Normansrule/solar-rover/hardware/stl/remote_case_bottom.stl

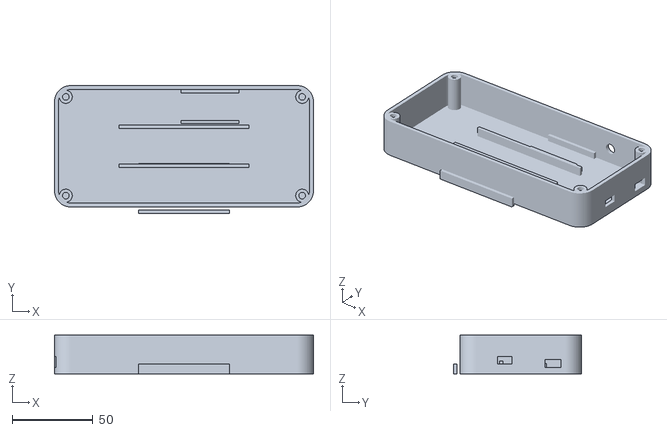
[picture p11: CAD file, 2026-11-06]
hardware/stl/remote_case_bottom.stl
160.0 x 79.0 x 24.0
