Normansrule/solar-rover/hardware/stl/roof_tray_rear.stl

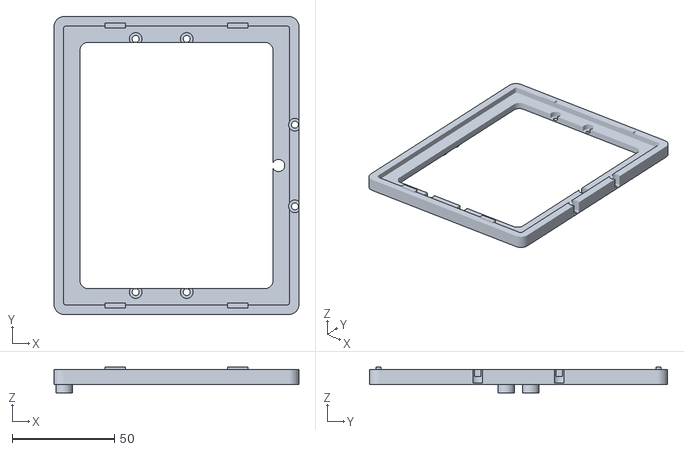
[picture p12: CAD file, 2026-11-06]
hardware/stl/roof_tray_rear.stl
120.0 x 146.0 x 12.6
