Normansrule/solar-rover/hardware/stl/module_cradle_e220.stl

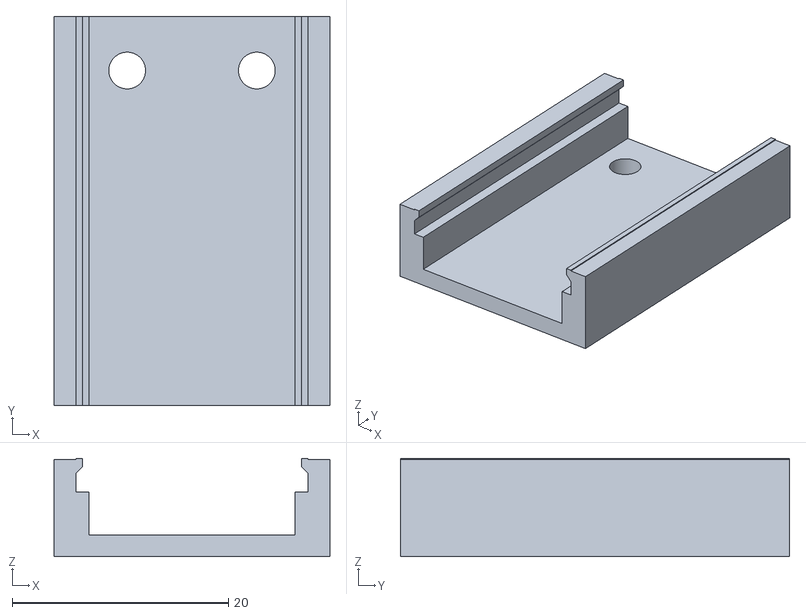
[picture p13: CAD file, 2026-11-06]
hardware/stl/module_cradle_e220.stl
25.5 x 36.0 x 9.10
