Normansrule/solar-rover/hardware/stl/tire.stl

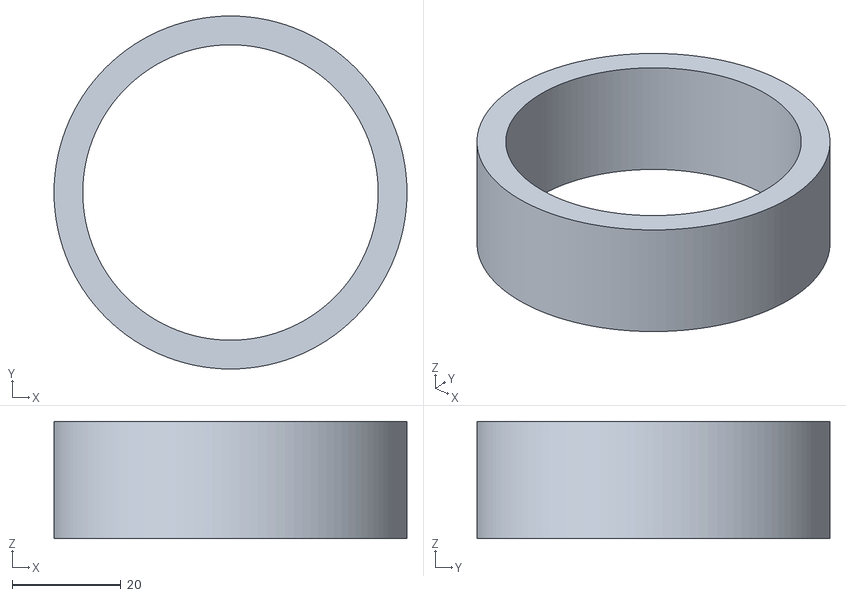
[picture p14: CAD file, 2026-10-18]
hardware/stl/tire.stl
65.0 x 65.0 x 21.6
