Normansrule/solar-rover/hardware/stl/upper_plate_idler.stl

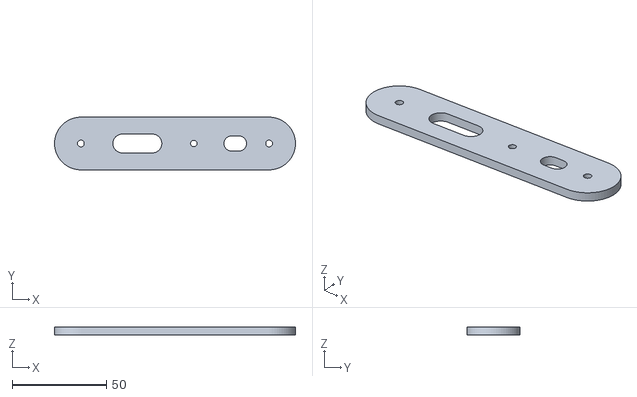
[picture p15: CAD file, 2026-10-18]
hardware/stl/upper_plate_idler.stl
128.0 x 28.0 x 4.00
