Normansrule/solar-rover/hardware/stl/wheel.stl

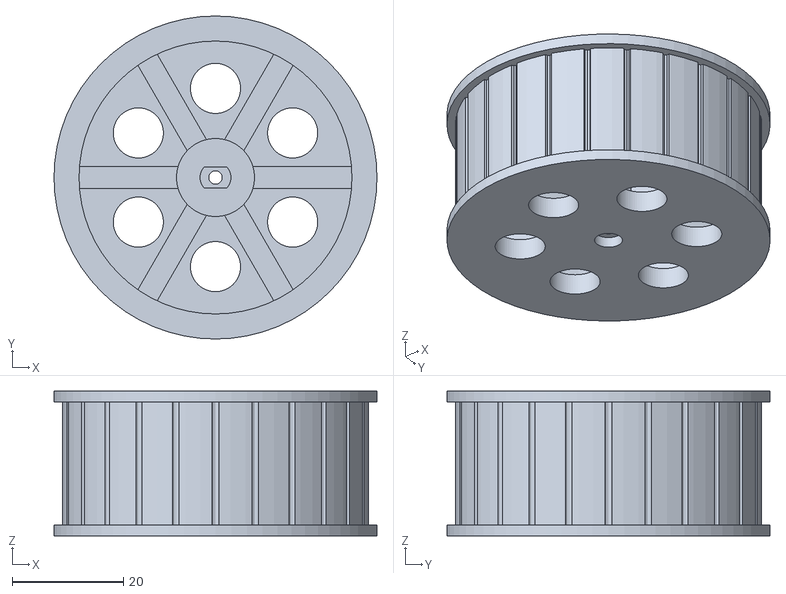
[picture p16: CAD file, 2026-10-18]
hardware/stl/wheel.stl
58.0 x 58.0 x 26.0
