Normansrule/solar-rover/hardware/stl/motor_clamp_a.stl

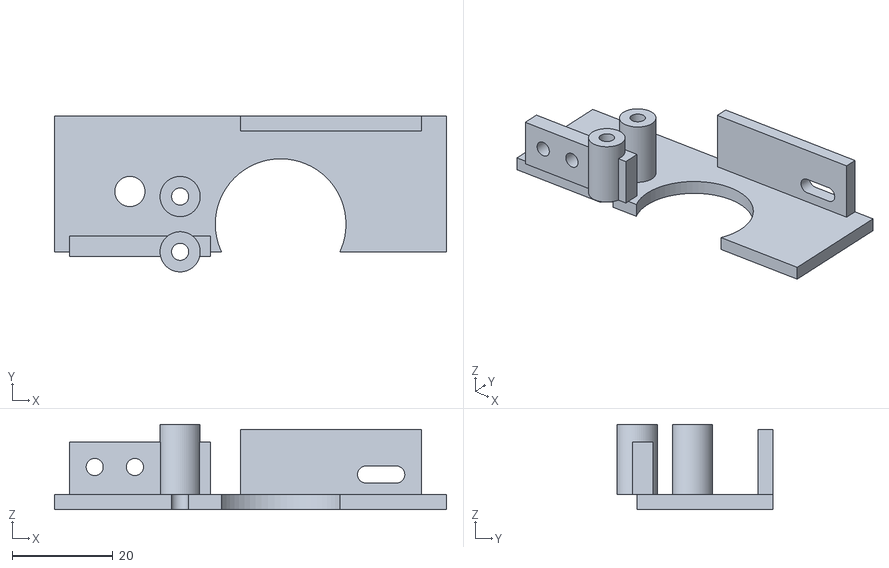
[picture p17: CAD file, 2026-10-18]
hardware/stl/motor_clamp_a.stl
78.0 x 31.0 x 17.0
