Normansrule/solar-rover/hardware/stl/tray_standoff.stl

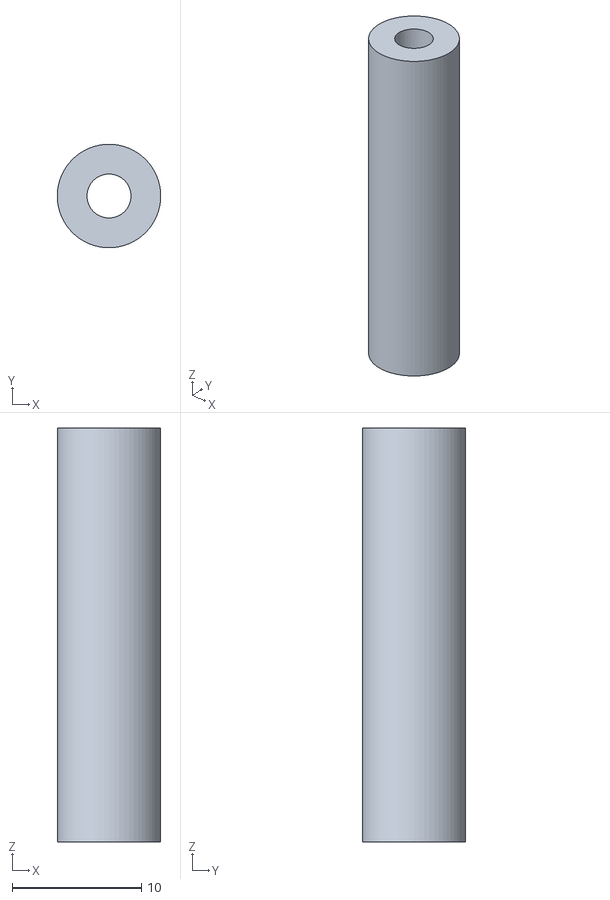
[picture p18: CAD file, 2026-10-18]
hardware/stl/tray_standoff.stl
8.00 x 8.00 x 32.0
