Normansrule/solar-rover/hardware/stl/encoder_disc.stl

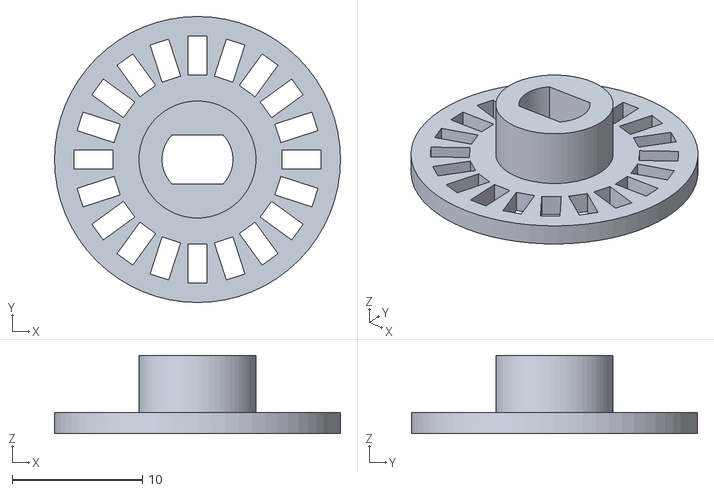
[picture p19: CAD file, 2026-10-18]
hardware/stl/encoder_disc.stl
22.0 x 22.0 x 6.00
