Normansrule/solar-rover/hardware/stl/finger_idler.stl

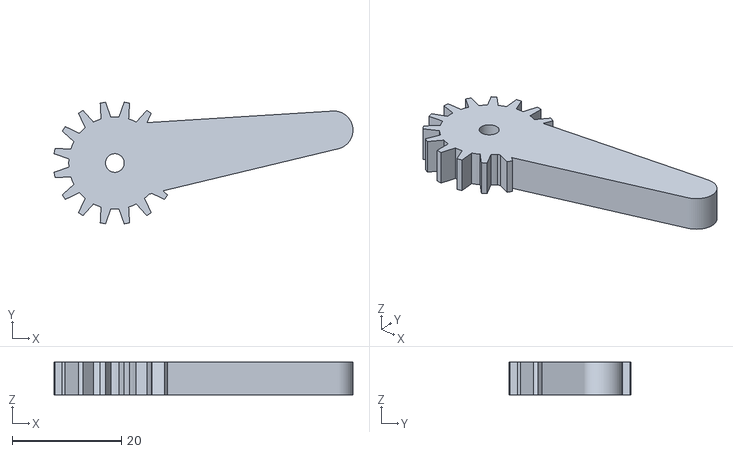
[picture p20: CAD file, 2026-10-18]
hardware/stl/finger_idler.stl
54.6 x 22.2 x 6.00
