Normansrule/solar-rover/hardware/stl/gripper_palm.stl

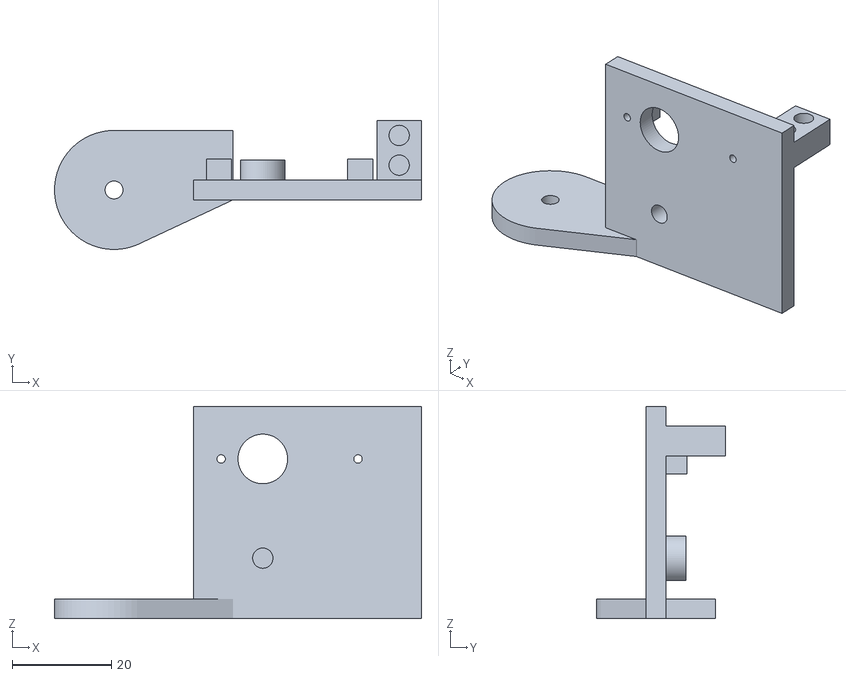
[picture p21: CAD file, 2026-10-18]
hardware/stl/gripper_palm.stl
74.0 x 26.0 x 42.8
