Normansrule/solar-rover/hardware/stl/remote_case_top.stl

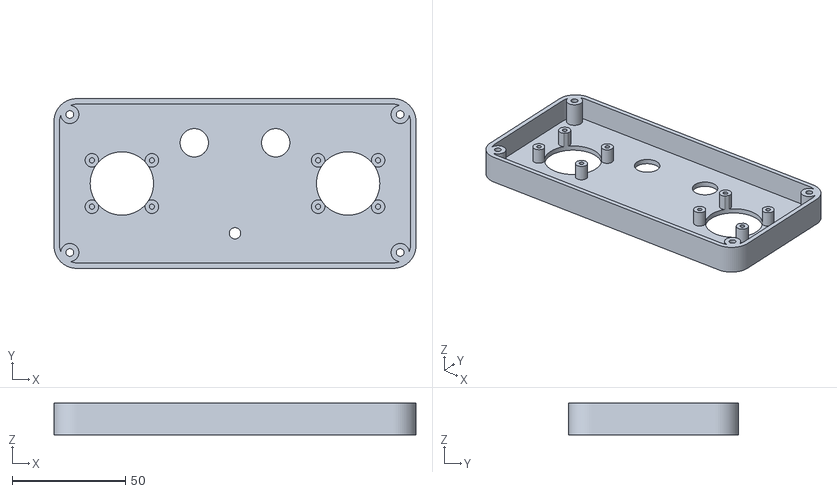
[picture p22: CAD file, 2026-10-18]
hardware/stl/remote_case_top.stl
160.0 x 75.0 x 14.0
