Normansrule/solar-rover/hardware/stl/roof_post.stl

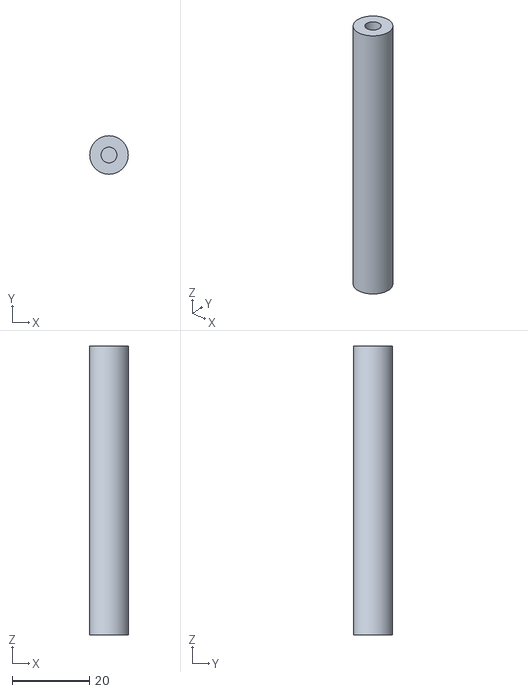
[picture p23: CAD file, 2026-10-18]
hardware/stl/roof_post.stl
10.0 x 10.0 x 75.0
