Normansrule/solar-rover/hardware/stl/charge_tray.stl

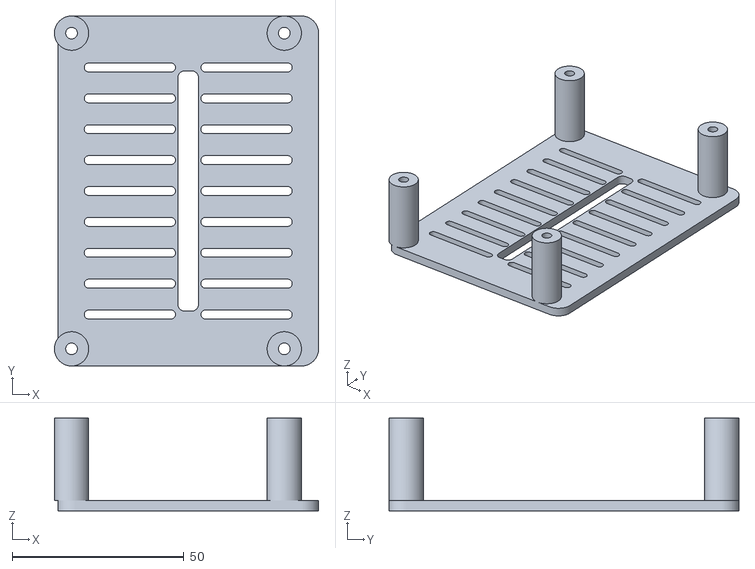
[picture p24: CAD file, 2026-10-18]
hardware/stl/charge_tray.stl
77.0 x 102.0 x 27.0
