Normansrule/solar-rover/hardware/stl/turret_top.stl

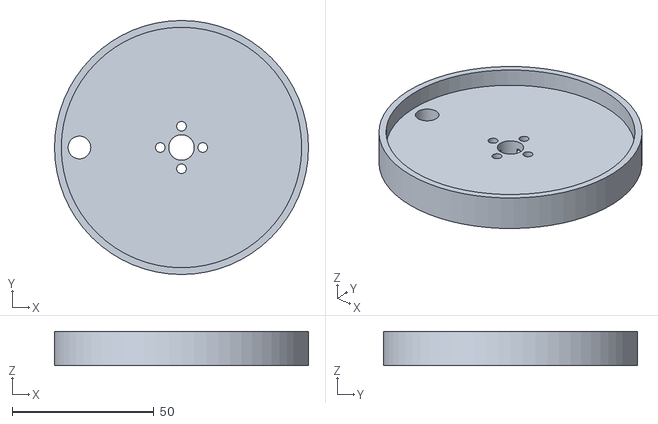
[picture p25: CAD file, 2026-10-18]
hardware/stl/turret_top.stl
89.6 x 89.6 x 12.0
