Normansrule/solar-rover/hardware/stl/module_cradle_mp1584.stl

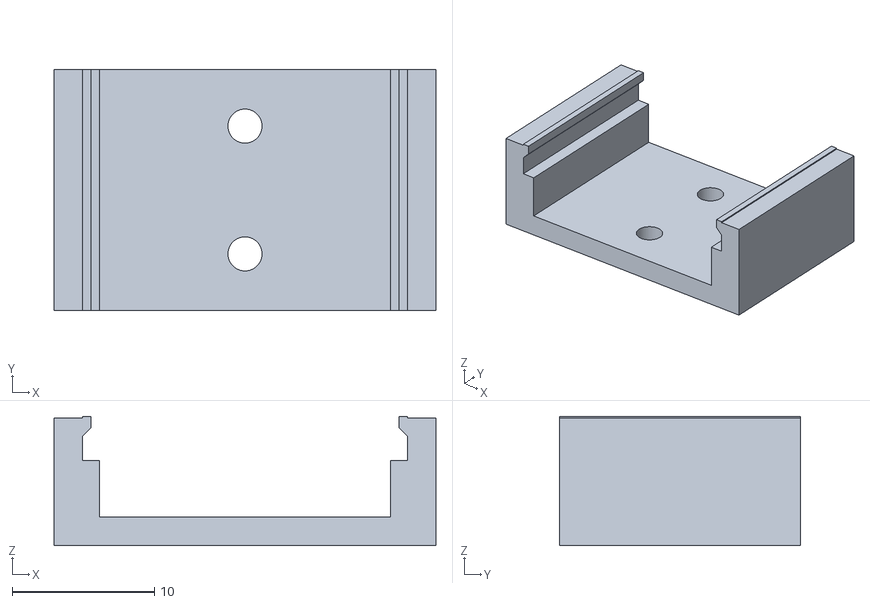
[picture p26: CAD file, 2026-10-18]
hardware/stl/module_cradle_mp1584.stl
26.9 x 17.0 x 9.10
