Normansrule/solar-rover/hardware/stl/shoulder_mount.stl

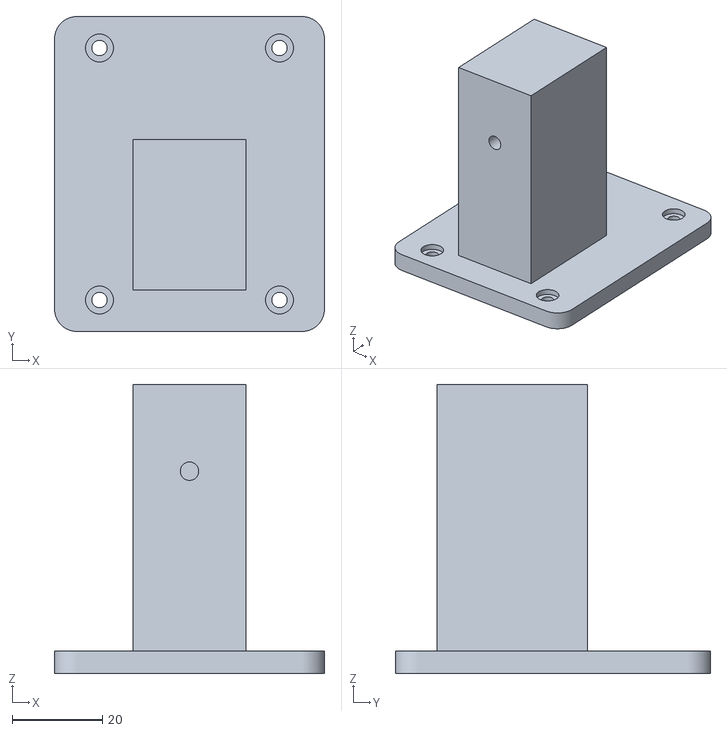
[picture p27: CAD file, 2026-10-18]
hardware/stl/shoulder_mount.stl
60.0 x 70.0 x 64.3
