Normansrule/solar-rover/hardware/stl/nose.stl

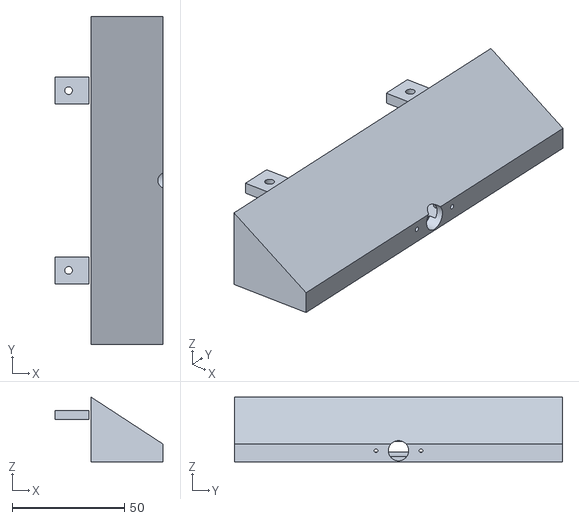
[picture p28: CAD file, 2026-10-18]
hardware/stl/nose.stl
48.0 x 146.0 x 28.9
