Normansrule/solar-rover/hardware/stl/gripper_horn_arm.stl

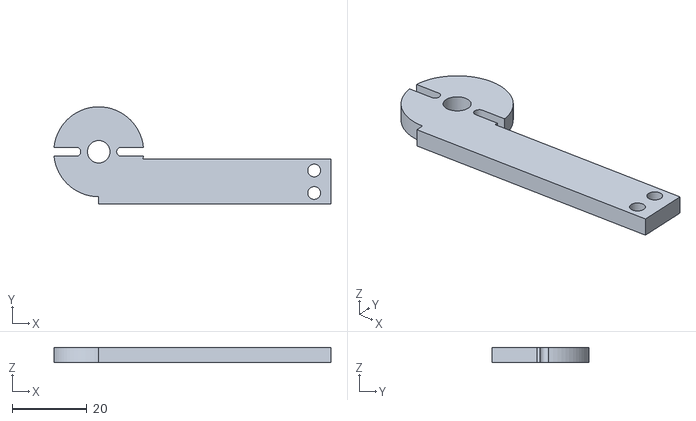
[picture p29: CAD file, 2026-10-18]
hardware/stl/gripper_horn_arm.stl
73.9 x 26.0 x 4.00
