Normansrule/solar-rover/hardware/stl/deck_front.stl

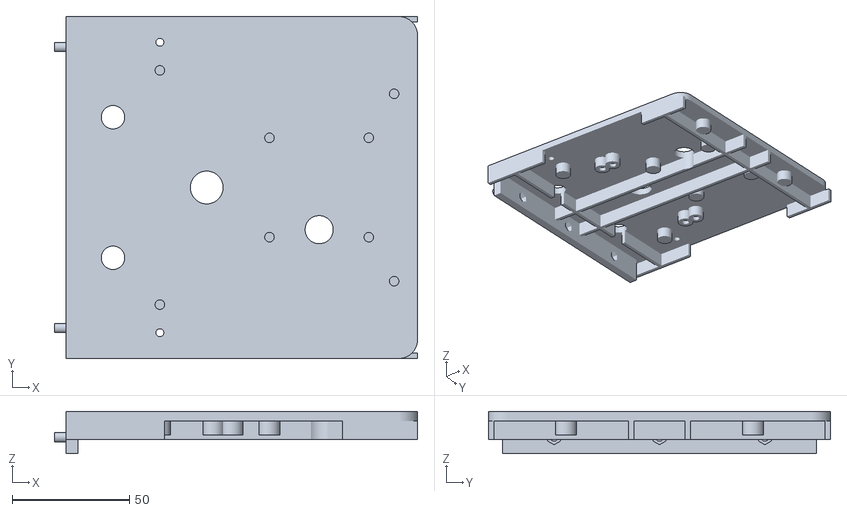
[picture p30: CAD file, 2026-10-18]
hardware/stl/deck_front.stl
155.0 x 146.0 x 18.0
