Normansrule/solar-rover/hardware/stl/forearm.stl

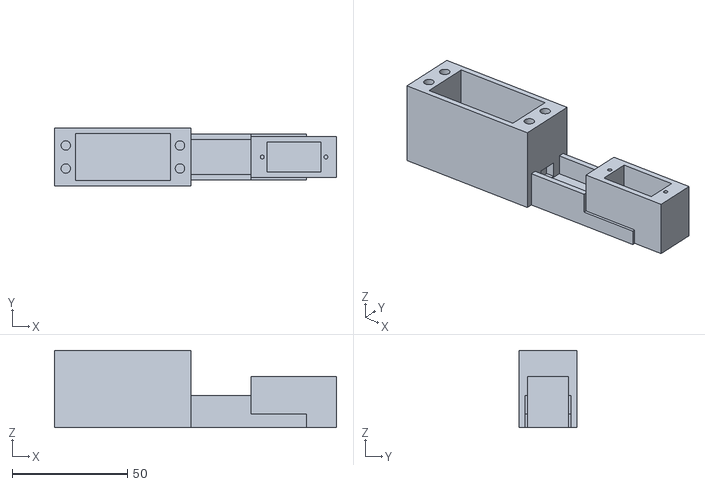
[picture p31: CAD file, 2026-10-18]
hardware/stl/forearm.stl
122.3 x 25.1 x 33.5
