Normansrule/solar-rover/hardware/stl/crossbar.stl

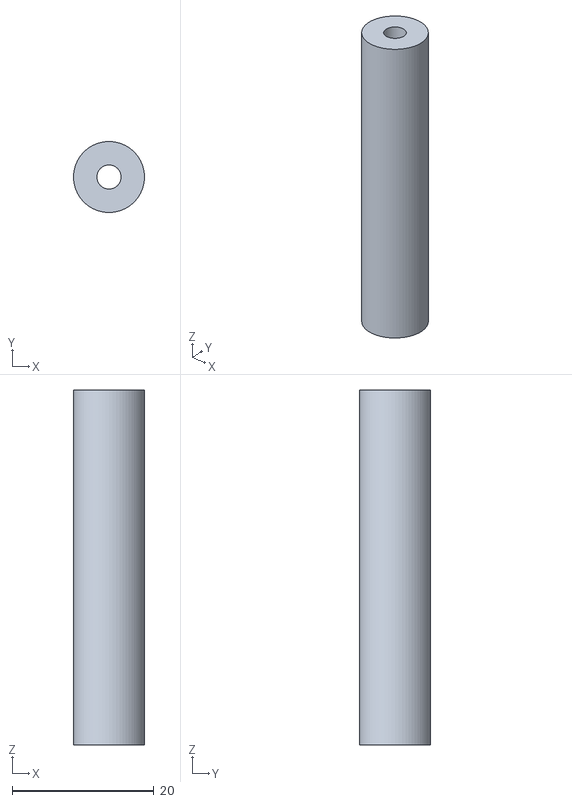
[picture p32: CAD file, 2026-10-18]
hardware/stl/crossbar.stl
10.0 x 10.0 x 50.0
