Normansrule/solar-rover/hardware/stl/deck_rear.stl

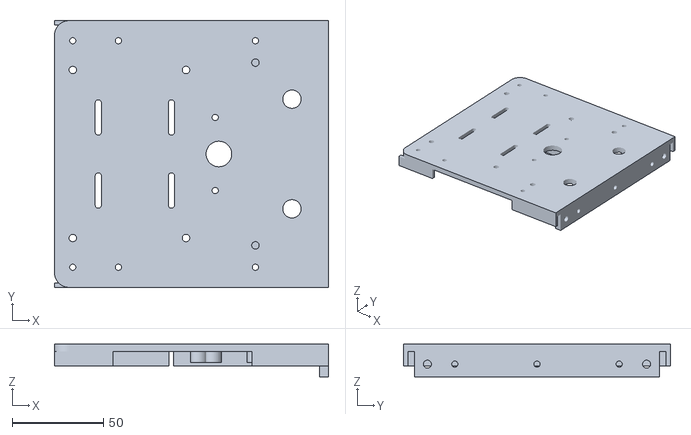
[picture p34: CAD file, 2026-10-18]
hardware/stl/deck_rear.stl
150.0 x 146.0 x 18.0
