Normansrule/solar-rover/hardware/stl/turret_base.stl

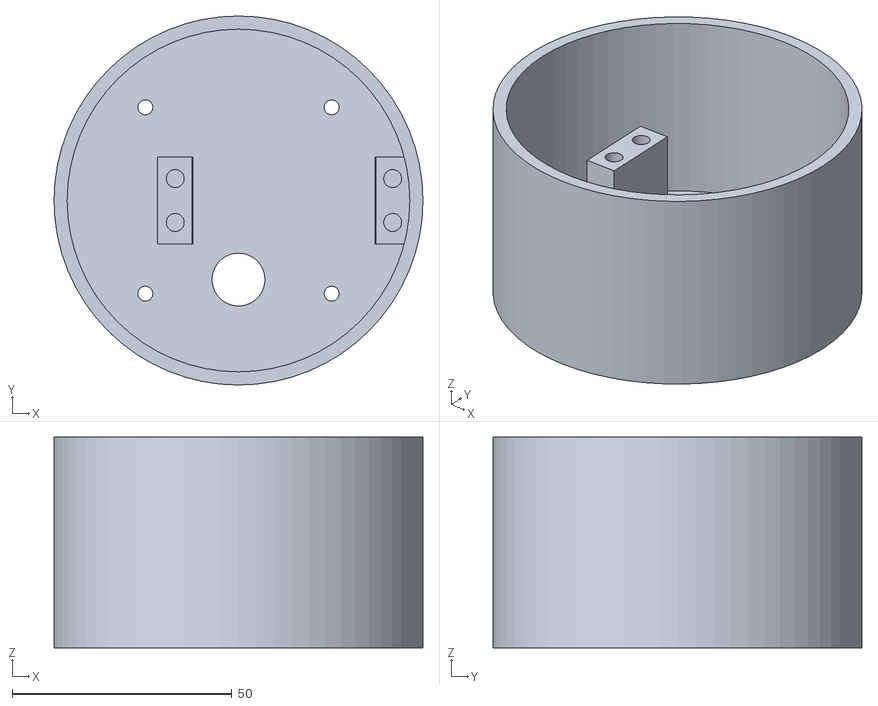
[picture p35: CAD file, 2026-10-18]
hardware/stl/turret_base.stl
84.0 x 84.0 x 48.0
