Normansrule/solar-rover/hardware/stl/power_tray.stl

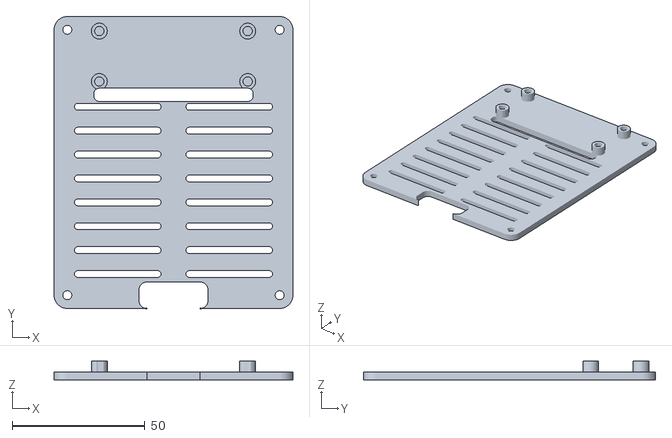
[picture p36: CAD file, 2026-10-18]
hardware/stl/power_tray.stl
90.0 x 110.0 x 7.00
