Normansrule/solar-rover/hardware/stl/logic_tray.stl

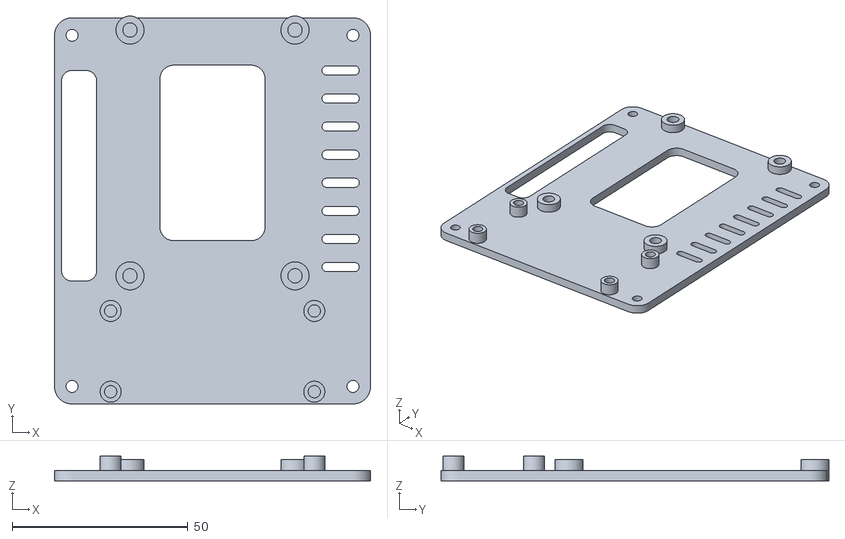
[picture p37: CAD file, 2026-10-18]
hardware/stl/logic_tray.stl
90.0 x 110.5 x 7.00
