Normansrule/solar-rover/hardware/stl/module_cradle_tb6612.stl

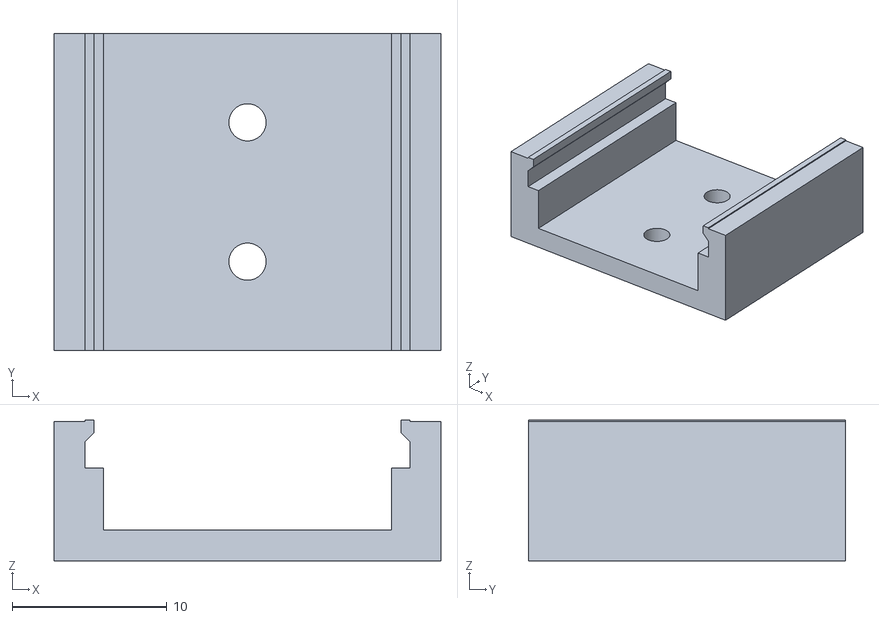
[picture p38: CAD file, 2026-10-18]
hardware/stl/module_cradle_tb6612.stl
25.0 x 20.5 x 9.10
