Normansrule/solar-rover/hardware/stl/roof_tray_front.stl

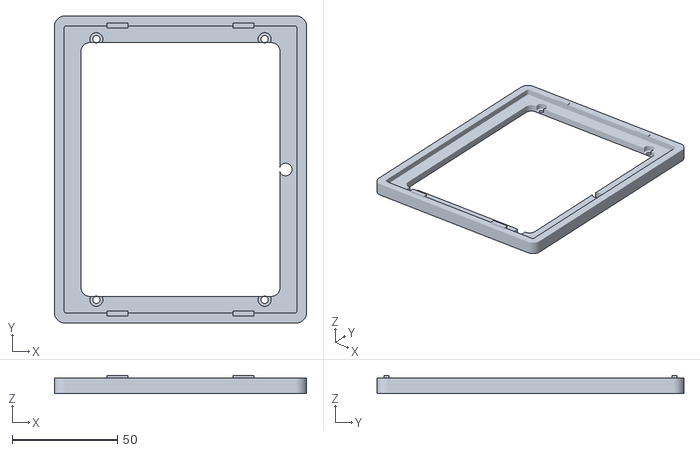
[picture p39: CAD file, 2026-10-18]
hardware/stl/roof_tray_front.stl
120.0 x 146.0 x 8.60
