Normansrule/solar-rover/hardware/stl/camera_mount.stl

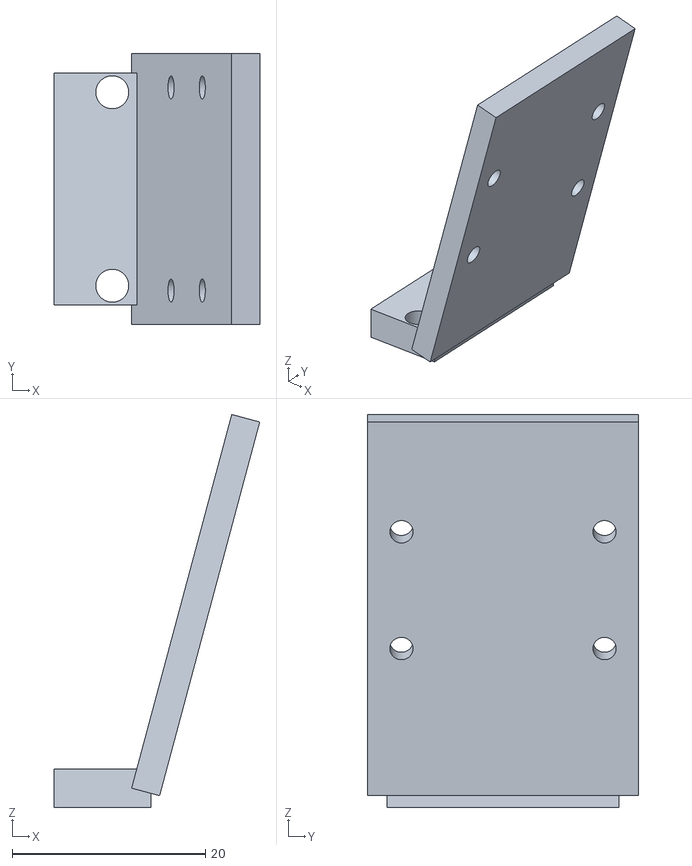
[picture p40: CAD file, 2026-10-18]
hardware/stl/camera_mount.stl
21.3 x 28.0 x 40.6
