Normansrule/solar-rover/(list of files, cad)

Other CAD files:
hardware/stl/finger_driven.stl
hardware/stl/motor_clamp_b.stl
