Normansrule/solar-rover/(commit log)

2026-10-18 Solar Rover v0.2: 3D parts, wiring, firmware, phone app, simulator and agent
    [assembly.scad, bom.csv, camera_mount.scad, camera_mount.stl, charge_tray.scad, charge_tray.stl, config.scad, crossbar.scad]
2026-10-25 Add a long-range LoRa link between the remote and the car
    E220-900T22D LoRa modules (UART) in the car and the handheld remote. The
    remote fails over from ESP-NOW to LoRa when deliveries stop and back when
    they return. Frames are SipHash-signed with a key handed over at pairing,
    counters block replays, the watchdog allows 700 ms on LoRa, top speed is
    cut to 60 %, and an airtime budget keeps the US/EU duty-cycle rules.
    Motor STBY moves to GPIO12 so the radio gets GPIO13/14 plus GPIO0 for its
    mode pins. New module_cradle_e220 hangs under the rear roof tray (2 new
    M3 bosses); the remote case gets rails and an SMA bulkhead hole. Docs,
    BOM, diagrams, progress and a PC test in CI updated.
    Co-Auth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
    [assembly.scad, bom.csv, config.scad, module_cradle.scad, module_cradle_e220.stl, remote_case.scad, remote_case_bottom.stl, roof_tray.scad]
2026-10-25 Rename the radio setup helper: setup() clashes with Arduino's
    Claude-Session: https://claude.ai/code/session_01L2UBB7kAgzdgEheFSHDMTT
